Luk9091/Analogi/Sprawko/Chapters/elementy.tex

\section{Elementy}
\begin{enumerate}
    \item Wzmacniacze operacyjne
        \begin{enumerate}
            \item INA186
            \item OPA350
        \end{enumerate}
    \item Mikrokontroler: STM32G4
    \item Napięcie referencyjne: MCP1501T-20E/CHY
    \item LDO: MIC5365/6 (150mA 3.3V)
\end{enumerate}
