Luk9091/Analogi/Schematic/current_measure.kicad_pcb

## KiCad design Schematic/current_measure.kicad_pcb (2025-11-18)

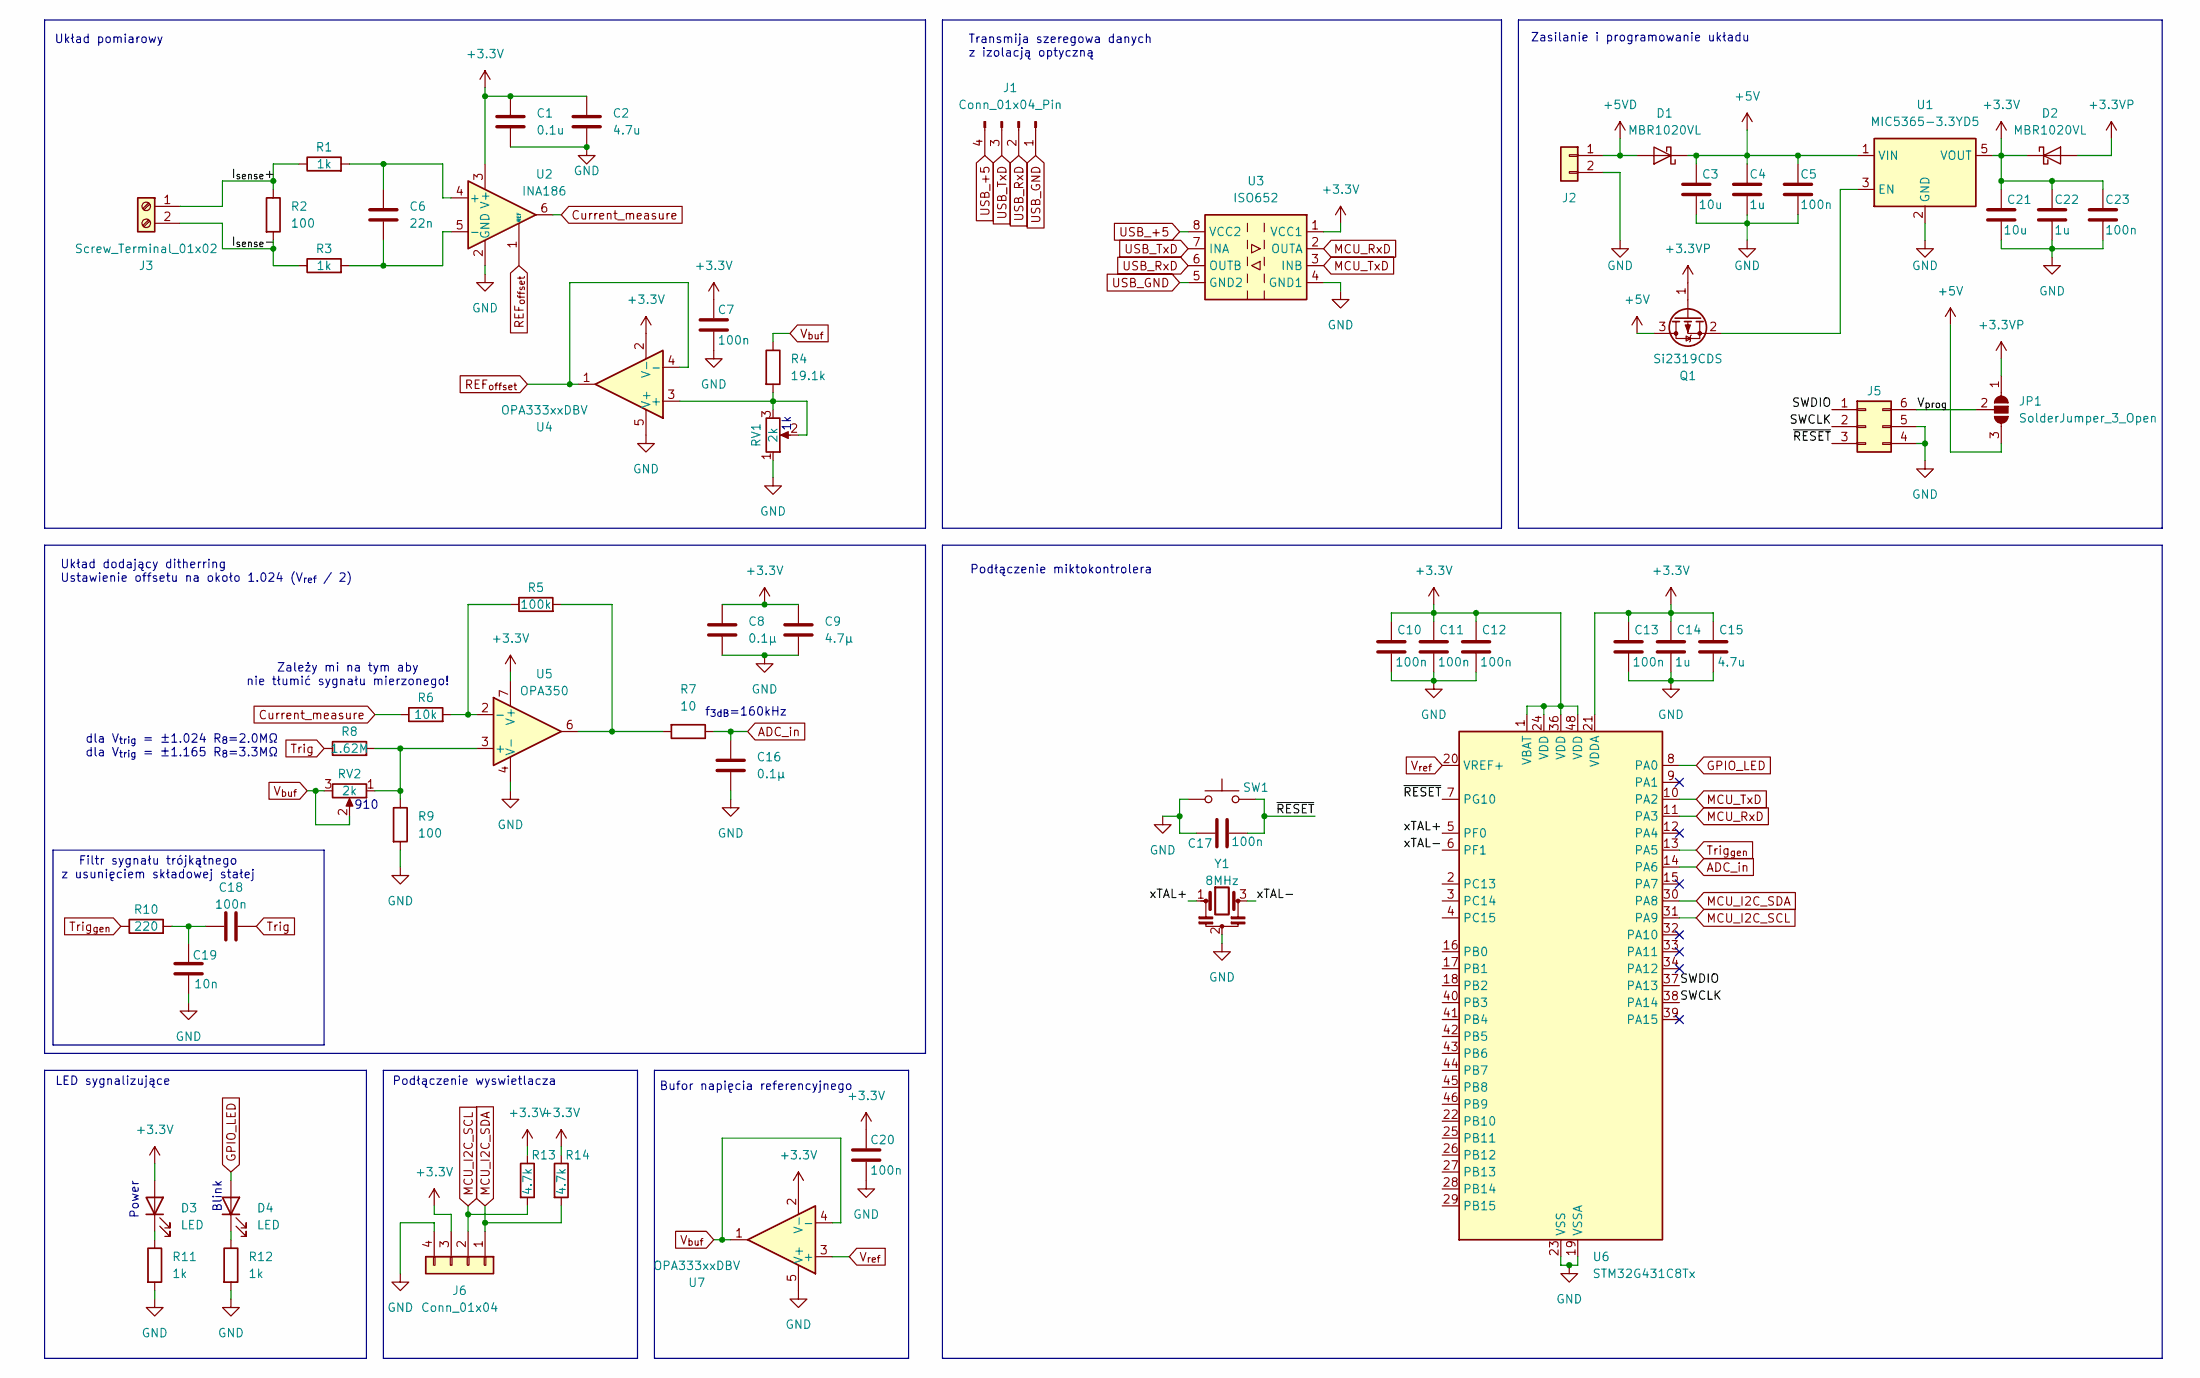
[picture p7: schematic current_measure.kicad_sch]

Parts:
C1: 0.1u; C_0805_2012Metric
C2, C15: 4.7u; C_0805_2012Metric
C3, C21: 10u; C_0805_2012Metric
C4, C14, C22: 1u; C_0805_2012Metric
C5, C7, C10, C11, C12, C13, C17, C18, C20, C23: 100n; C_0805_2012Metric
C6: 22n; C_0805_2012Metric
C8, C16: 0.1µ; C_0805_2012Metric
C9: 4.7µ; C_0805_2012Metric
C19: 10n; C_0805_2012Metric
D1, D2: MBR1020VL; D_SOD-123F
D3, D4: LED; LED_0805_2012Metric_Pad1.15x1.40mm_HandSolder
J1: Conn_01x04_Pin; PinHeader_1x04_P2.54mm_Vertical
J2: Conn_01x02; PinHeader_1x02_P2.54mm_Vertical
J3: Screw_Terminal_01x02; TerminalBlock_Xinya_XY308-2.54-2P_1x02_P2.54mm_Horizontal
J5: Conn_02x03_Counter_Clockwise; PinSocket_2x03_P2.54mm_Vertical
J6: Conn_01x04; PinSocket_1x04_P2.54mm_Vertical
JP1: SolderJumper_3_Open; SolderJumper-3_P1.3mm_Open_Pad1.0x1.5mm
Q1: Si2319CDS; SOT-23
R1, R3, R11, R12: 1k; R_0805_2012Metric
R2, R9: 100; R_0805_2012Metric
R4: 19.1k; R_0805_2012Metric
R5: 100k; R_0805_2012Metric
R6: 10k; R_0805_2012Metric
R7: 10; R_0805_2012Metric
R8: 1.62M; R_0805_2012Metric
R10: 220; R_0805_2012Metric
R13, R14: 4.7k; R_0805_2012Metric
RV1, RV2: 2k; Potentiometer_Bourns_3296Z_Horizontal
SW1: SW_Push; SW_SPST_PTS647_Sx38
U1: MIC5365-3.3YD5; TSOT-23-5_HandSoldering
U2: INA186; SOT-363_SC-70-6_Handsoldering
U3: ISO652; SOIC-8_3.9x4.9mm_P1.27mm
U4: OPA333xxDBV; SOT-23-5
U5: OPA350; SOIC-8_3.9x4.9mm_P1.27mm
U6: STM32G431C8Tx; LQFP-48_7x7mm_P0.5mm
U7: OPA333xxDBV; SOT-23-5_HandSoldering
Y1: 8MHz; Resonator_SMD_Murata_CSTxExxV-3Pin_3.0x1.1mm

Connections:
+3.3V: C1.1, C2.1, C7.1, C8.1, C9.1, C10.1, C11.1, C12.1, C13.1, C14.1, C15.1, C20.1, C21.1, C22.1, C23.1, D2.1 (K), D3.2 (A), J6.3, R13.1, R14.1, U1.5 (VOUT), U2.3 (V+), U3.1 (VCC1), U4.2 (V-), U5.7 (V+), U6.1 (VBAT), U6.21 (VDDA), U6.24 (VDD), U6.36 (VDD), U6.48 (VDD), U7.2 (V-)
+3.3VP: D2.2 (A), JP1.1 (A), Q1.1 (G)
+5V: C3.1, C4.1, C5.1, D1.1 (K), JP1.3 (B), Q1.3 (D), U1.1 (VIN)
+5VD: D1.2 (A), J2.1
/I_{sense}+: J3.1, R1.1, R2.1
/I_{sense}-: J3.2, R2.2, R3.1
/SWCLK: J5.2, U6.38 (PA14)
/SWDIO: J5.1, U6.37 (PA13)
/V_{prog}: J5.6, JP1.2 (C)
/xTAL+: U6.5 (PF0), Y1.1
/xTAL-: U6.6 (PF1), Y1.3
/~RESET: C17.1, J5.3, SW1.2, U6.7 (PG10)
ADC_in: C16.1, R7.1, U6.14 (PA6)
Current_measure: R6.1, U2.6
GND: C1.2, C2.2, C3.2, C4.2, C5.2, C7.2, C8.2, C9.2, C10.2, C11.2, C12.2, C13.2, C14.2, C15.2, C16.2, C17.2, C19.2, C20.2, C21.2, C22.2, C23.2, J2.2, J5.4, J5.5, J6.4, R9.2, R11.2, R12.2, RV1.1, SW1.1, U1.2 (GND), U2.2 (GND), U3.4 (GND1), U4.5 (V+), U5.4 (V-), U6.19 (VSSA), U6.23 (VSS), U6.35 (VSS), U6.47 (VSS), U7.5 (V+), Y1.2
GPIO_LED: D4.2 (A), U6.8 (PA0)
MCU_I2C_SCL: J6.2, R13.2, U6.31 (PA9)
MCU_I2C_SDA: J6.1, R14.2, U6.30 (PA8)
MCU_RxD: U3.2 (OUTA), U6.11 (PA3)
MCU_TxD: U3.3 (INB), U6.10 (PA2)
unnamed: C18.1, C19.1, R10.2
unnamed: D3.1 (K), R11.1
unnamed: D4.1 (K), R12.1
unnamed: Q1.2 (S), U1.3 (EN)
unnamed: R5.2, R7.2, U5.6
unnamed: C6.1, R1.2, U2.4 (+)
unnamed: C6.2, R3.2, U2.5 (-)
unnamed: R4.2, RV1.2, RV1.3, U4.3 (+)
unnamed: R8.2, R9.1, RV2.1, U5.3 (+)
unnamed: R5.1, R6.2, U5.2 (-)
REF_{offset}: U2.1 (REF), U4.1, U4.4 (-)
Trig: C18.2, R8.1
Trig_{gen}: R10.1, U6.13 (PA5)
USB_+5: J1.4, U3.8 (VCC2)
USB_GND: J1.1, U3.5 (GND2)
USB_RxD: J1.2, U3.6 (OUTB)
USB_TxD: J1.3, U3.7 (INA)
V_{buf}: R4.1, RV2.2, RV2.3, U7.1, U7.4 (-)
V_{ref}: U6.20 (VREF+), U7.3 (+)

Notes on the sheet:
Podłączenie wyswietlacza
Transmija szeregowa danych z izolacją optyczną
Podłączenie miktokontrolera
Układ pomiarowy
LED sygnalizujące
Zależy mi na tym aby nie tłumić sygnału mierzonego!
910
Filtr sygnału trójkątnego z usunięciem składowej stałej
Bufor napięcia referencyjnego
Zasilanie i programowanie układu
Power
Blink
f_{3dB}=160kHz
Układ dodający ditherring Ustawienie offsetu na około 1.024 (V_{ref} / 2)
dla V_{trig} = ±1.024 R_{8}=2.0MΩ dla V_{trig} = ±1.165 R_{8}=3.3MΩ

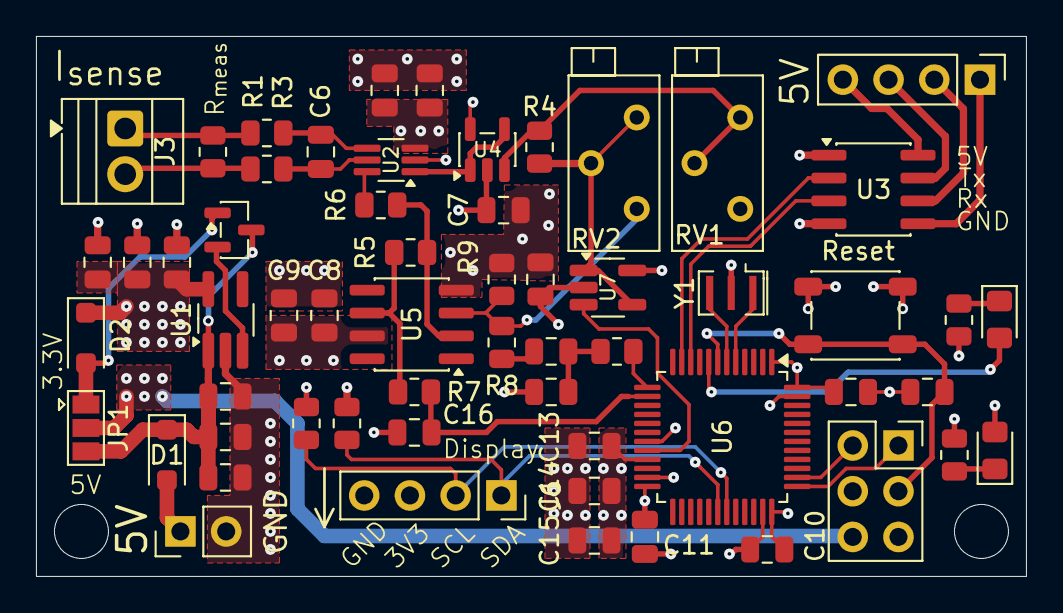
[picture p8: board current_measure.kicad_pcb from above]

Board: 4 copper layers, 55.0 x 30.0 mm, 59 parts (0 on the bottom side), 39 nets.
