Luk9091/Analogi/current_measure_src/current_measure.ioc

Mcu.UserName=STM32G431C6Tx
PA0.GPIO_Label=STATE_LED
PA0.Signal=GPIO_Output
PA13.Signal=SYS_JTMS-SWDIO
PA14.Signal=SYS_JTCK-SWCLK
PA2.Signal=USART2_TX
PA3.Signal=USART2_RX
PA5.GPIO_Label=TRIG
PA5.Signal=COMP_DAC12_group
PA6.Signal=ADC2_IN3
PA8.Signal=I2C2_SDA
PA9.Signal=I2C2_SCL
PF0-OSC_IN.Signal=RCC_OSC_IN
PF1-OSC_OUT.Signal=RCC_OSC_OUT
