Luk9091/Analogi/current_measure_src/Core/Inc/main.h

#define STATE_LED_Pin GPIO_PIN_0
#define STATE_LED_GPIO_Port GPIOA
#define TRIG_Pin GPIO_PIN_5
#define TRIG_GPIO_Port GPIOA
