Luk9091/Analogi/(commit log)

2025-10-21 Add parameters
    [current_measure.kicad_pcb, current_measure.kicad_sch]
2025-10-29 Week 27.10.2025
    [current_measure.kicad_sch]
2025-11-03 Week 03.11.2025
    [current_measure.kicad_sch]
2025-11-04 Update schematic
    [current_measure.kicad_sch]
2025-11-04 Clean schematic
    [current_measure.kicad_sch]
2025-11-09 Update simulation
    [current_measure.kicad_sch]
2025-11-12 Initial PCB
    [current_measure.kicad_pcb, current_measure.kicad_sch]
2025-11-13 PCB small
    [current_measure.kicad_pcb, current_measure.kicad_sch]
2025-11-18 Fix small issues with I2C and add power cap
    [current_measure.kicad_pcb, current_measure.kicad_sch]
