Luk9091/Analogi/(notices)

Notices in the files:
current_measure_src/Core/Src/i2c.c:
Copyright (c) 2025 STMicroelectronics.
All rights reserved.
This software is licensed under terms that can be found in the LICENSE file
